ryansimoneau1/Ukemaster3000_SeniorCapstone/README.md

# Ukemaster3000_SeniorCapstone
This is my Senior Capstone project completed at the University of Florida in May of 2023. The Ukemaster 3000 was capable of recording a song and playing it back on the Ukulele.
