ryansimoneau1/Ukemaster3000_SeniorCapstone/Volume Indicator Schematic.pdf

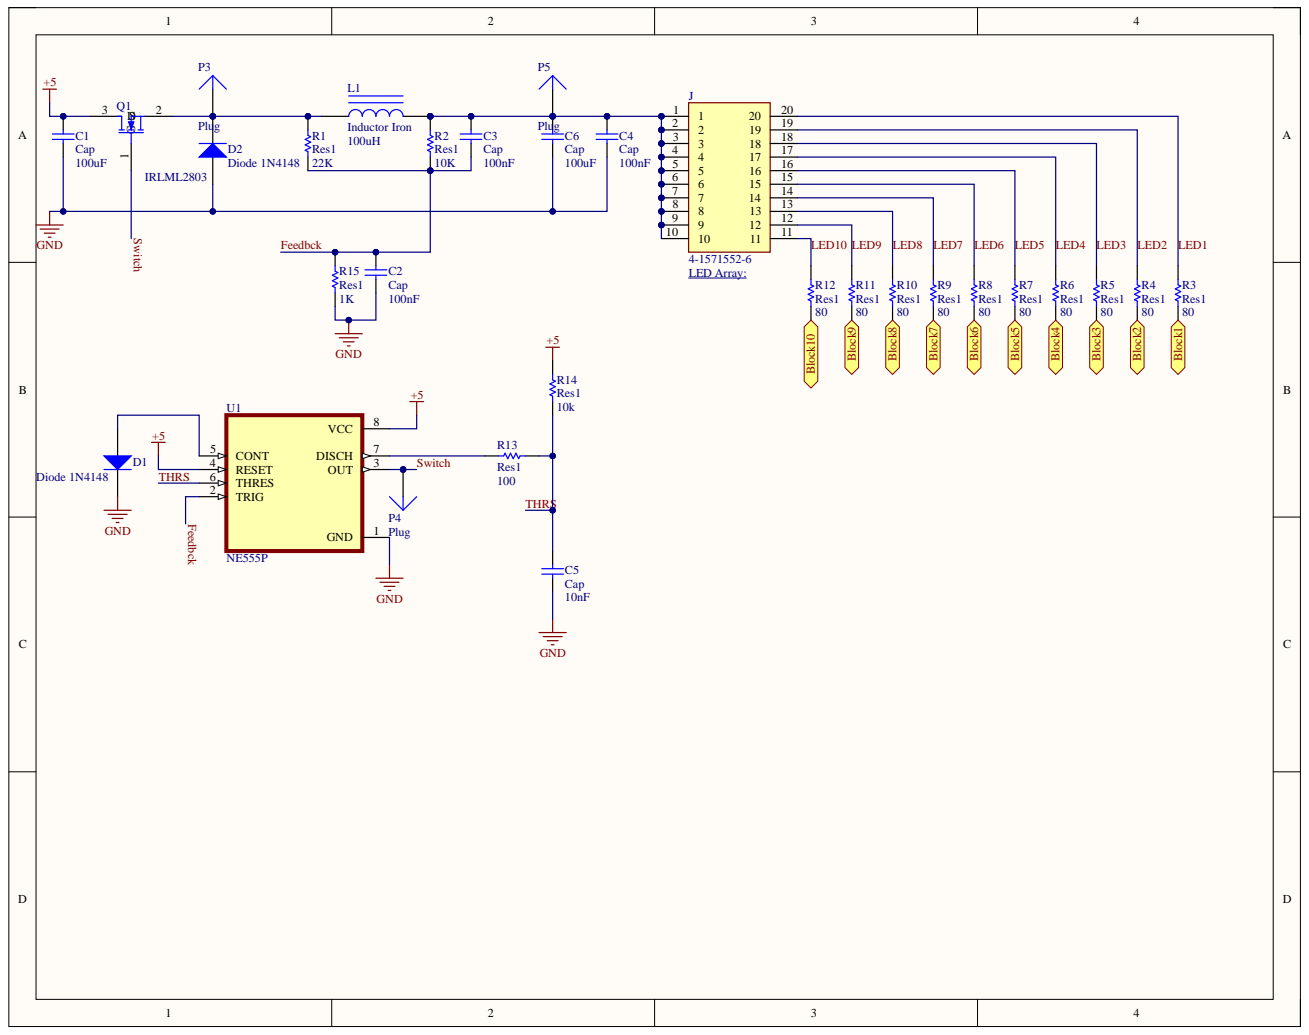
[picture p40: page 1]

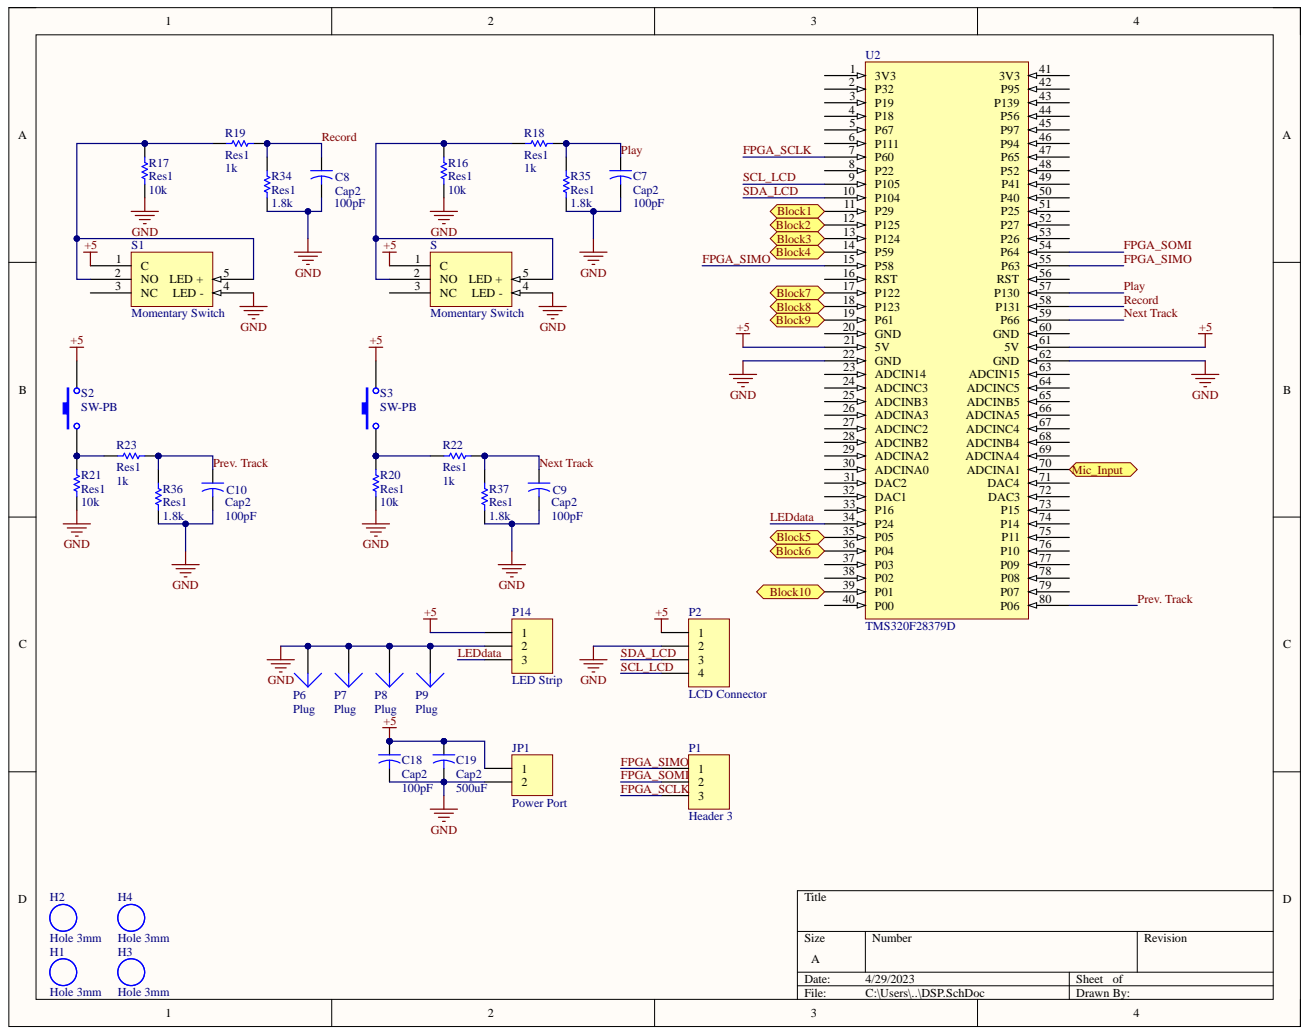
[picture p41: page 2]

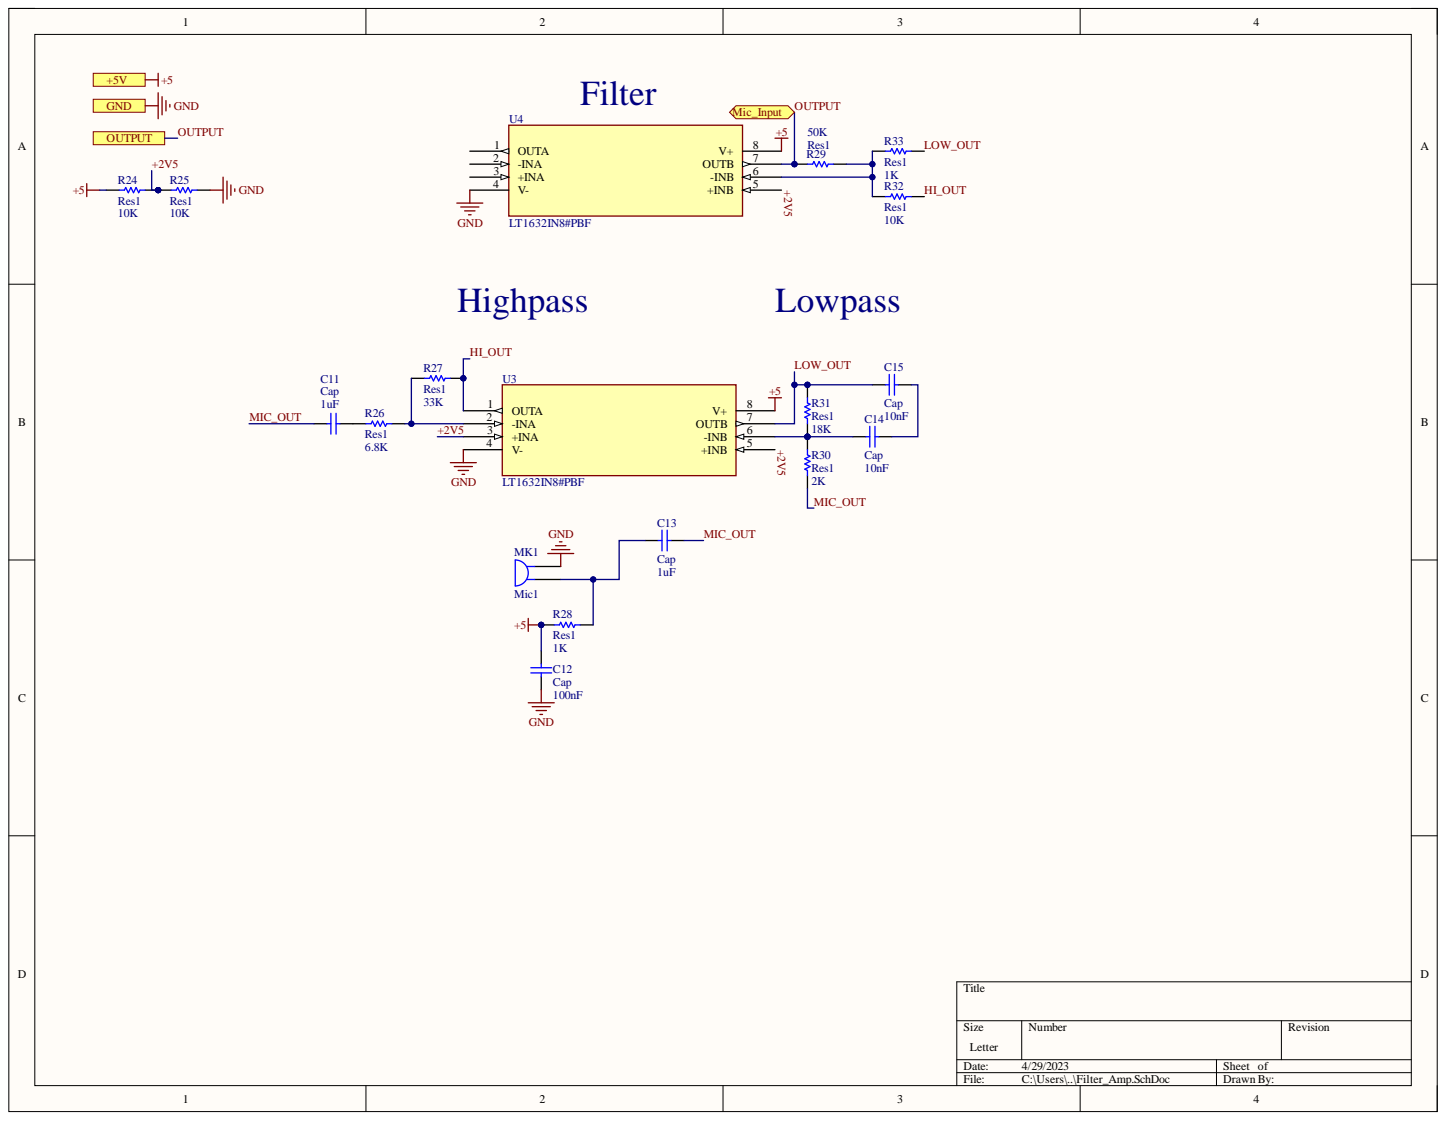
[picture p42: page 3]
