ryansimoneau1/Ukemaster3000_SeniorCapstone/LTSpice/Class Example Buck.asc

C1: cap; 100n
C2: cap; 22µ
C3: cap; 100µ
C4: cap; 100n
C5: cap; 10n
C6: cap; 100n
D1: diode; 1N5819
D2: diode; 1N4148
L1: ind; 100µ
M1: nmos; MM
R1: res; 80
R2: res; 22k
R3: res; 10k
R4: res; 1k
R5: res; 100
R6: res; 10k
U1: NE555
V1: voltage; 5
Named nets: 0, Switch, Out, Vcc, TRIG
.MODEL MM NMOS LEVEL=1 IS=1e-32
+VTO=2.08819 LAMBDA=0.0038193 KP=67.9211
+CGSO=1.59143e-05 CGDO=3.04562e-08
.inc D:\\Users\\ryans\\Downloads\\en.ST_power_schottky_diodes_pspice_models_v6/ST_POWER_SCHOTTKY_V9.LIB
.tran 20m
