ryansimoneau1/Ukemaster3000_SeniorCapstone/LTSpice/Converter.asc

C1: cap; 10µ
C2: cap; 10n
C3: cap; 10n
C4: cap; 100µ
C5: cap; 10n
D1: diode; 1N4148
D2: schottky; 1N5822
L1: ind; 10µ
M1: nmos; MM
R1: res; 10k
R2: res; 100
R3: res; 220k
R4: res; 10k
R6: res; 100
R7: res; 1k
U1: NE555
V1: voltage; 5; Rser=.1
Named nets: 0, Vcc
.tran 0 0.005 0 0.00001
.MODEL MM NMOS LEVEL=1 IS=1e-32
+VTO=2.08819 LAMBDA=0.0038193 KP=67.9211
+CGSO=1.59143e-05 CGDO=3.04562e-08
.inc D:\\Users\\ryans\\Downloads\\en.ST_power_schottky_diodes_pspice_models_v6/ST_POWER_SCHOTTKY_V9.LIB
