ryansimoneau1/Ukemaster3000_SeniorCapstone/LTSpice/Improved Converter.asc

C1: cap; 100µ
C2: cap; 100n
C3: cap; 1n
D1: schottky; 1n4148
D2: schottky; 1n4148
D3: schottky; 1N5822
L1: ind; 100µ
M1: nmos; MM
R1: res; 1k
R2: res; 5.761
R3: res; 37k
R4: res; 13k
U1: NE555
V1: voltage; 5; Rser=.1
Named nets: 0, Vcc, THRS
.tran 0 60m 0 10u
.MODEL MM NMOS LEVEL=1 IS=1e-32
+VTO=2.08819 LAMBDA=0.0038193 KP=67.9211
+CGSO=1.59143e-05 CGDO=3.04562e-08
.inc D:\\Users\\ryans\\Downloads\\en.ST_power_schottky_diodes_pspice_models_v6/ST_POWER_SCHOTTKY_V9.LIB
